vad7/Boiler_disable_frost_protection/Котел-Разъем.jpg

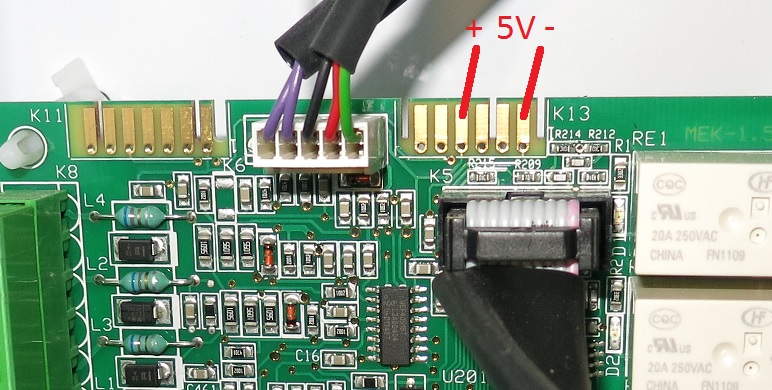
Котел-Разъем.jpg
