vad7/Boiler_disable_frost_protection/Attiny13A_Fuses.png

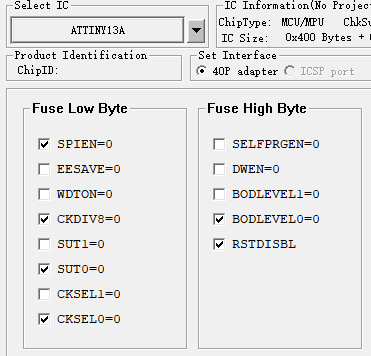
Attiny13A_Fuses.png
