vad7/Boiler_disable_frost_protection/Protherm NTC Sensor table.jpg

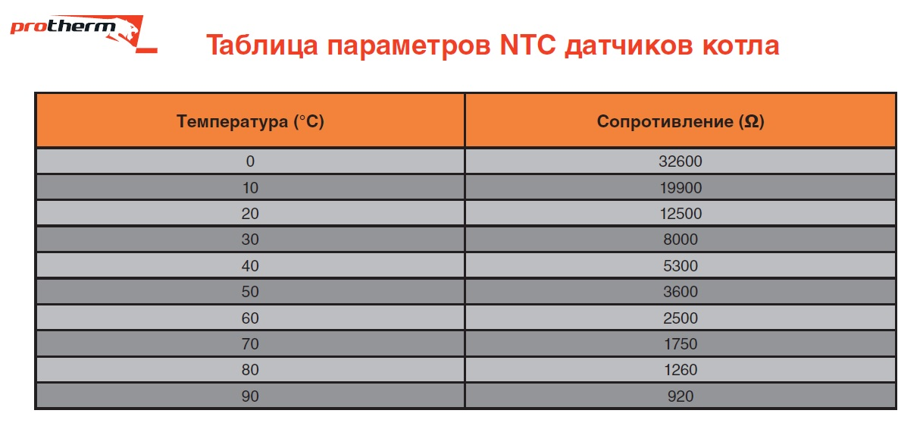
Protherm NTC Sensor table.jpg
