vad7/Boiler_disable_frost_protection/Schematic_Relay1-Heater-220V_v1.1.pdf

# 78L05Vout

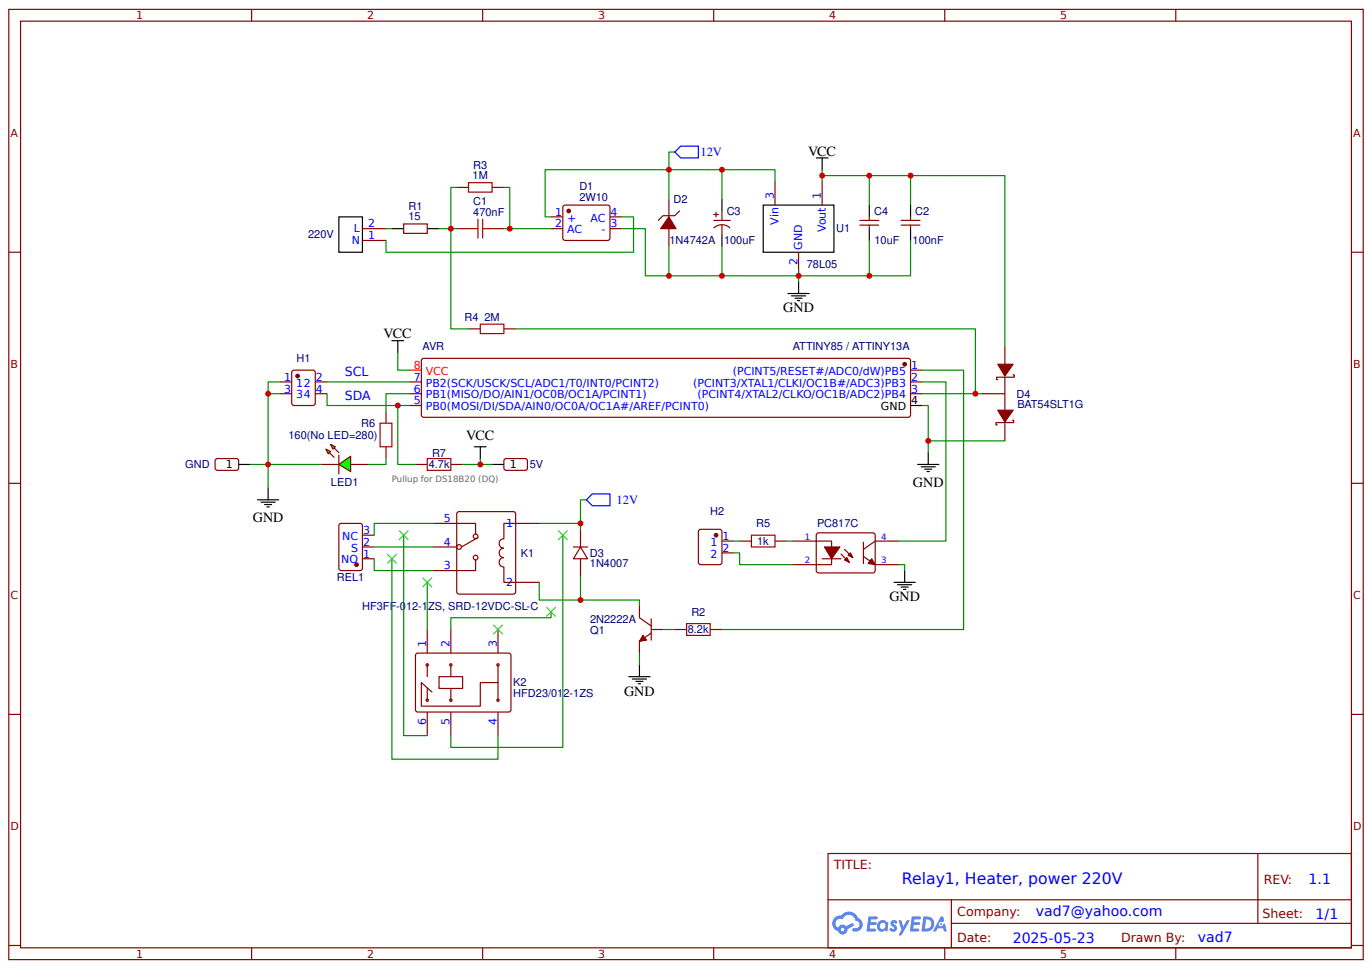
[picture p4: page 1]

GND 4 PB0(MOSI/DI/SDA/AIN0/OC0A/OC1A#/AREF/PCINT0) 5 PB1(MISO/DO/AIN1/OC0B/OC1A/PCINT1) 6 PB2(SCK/USCK/SCL/ADC1/T0/INT0/PCINT2) 7 VCC 8
